MilesMayhew/Pedagogical-PCB/STM32 Resources/STM32_Pinout.jpeg

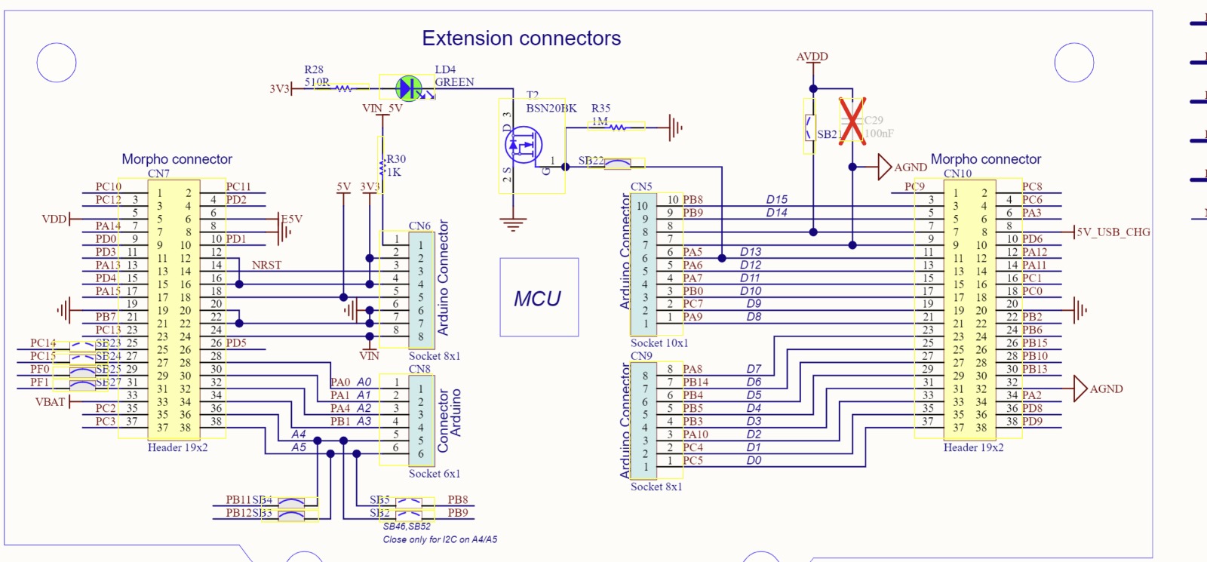
STM32 Resources/STM32_Pinout.jpeg
