MilesMayhew/Pedagogical-PCB/Reference Designs/Motor Driver Project 3d Model.jpg

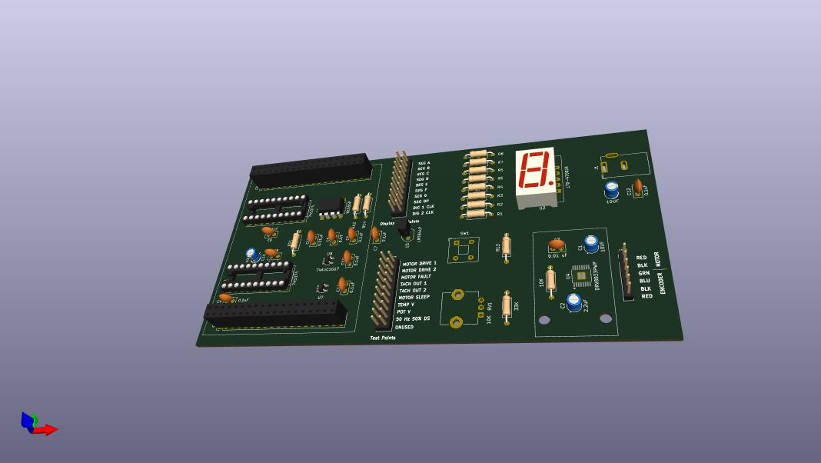
Reference Designs/Motor Driver Project 3d Model.jpg
