MilesMayhew/Pedagogical-PCB/Reference Designs/Motor Driver Project REV. 1.4.pdf

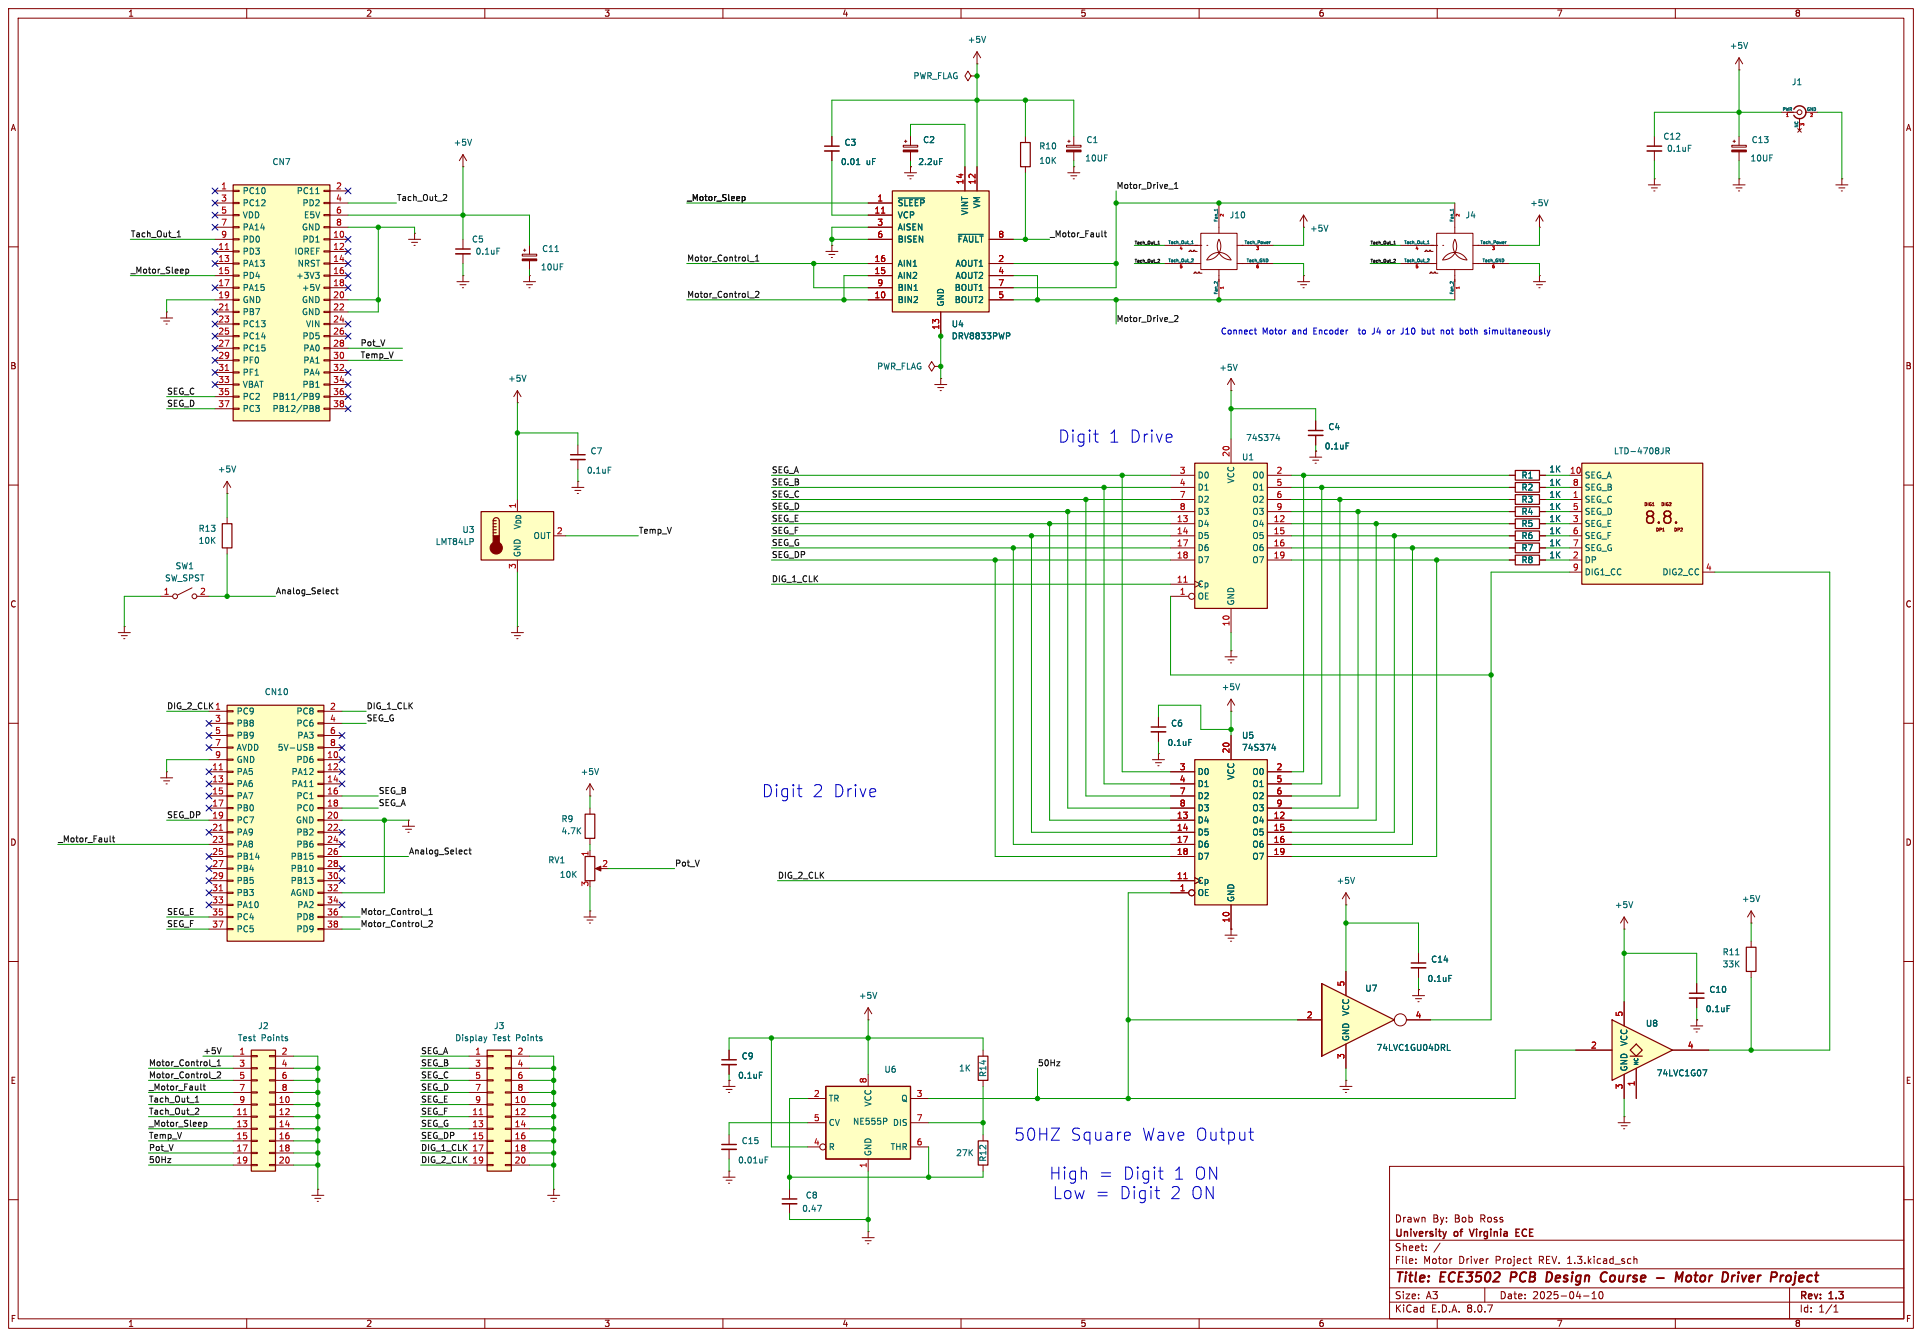
[picture p3: page 1]
