MilesMayhew/Pedagogical-PCB/PCBRev2/PCBRev2.kicad_pcb

## KiCad design PCBRev2/PCBRev2.kicad_pcb (2025-11-20)

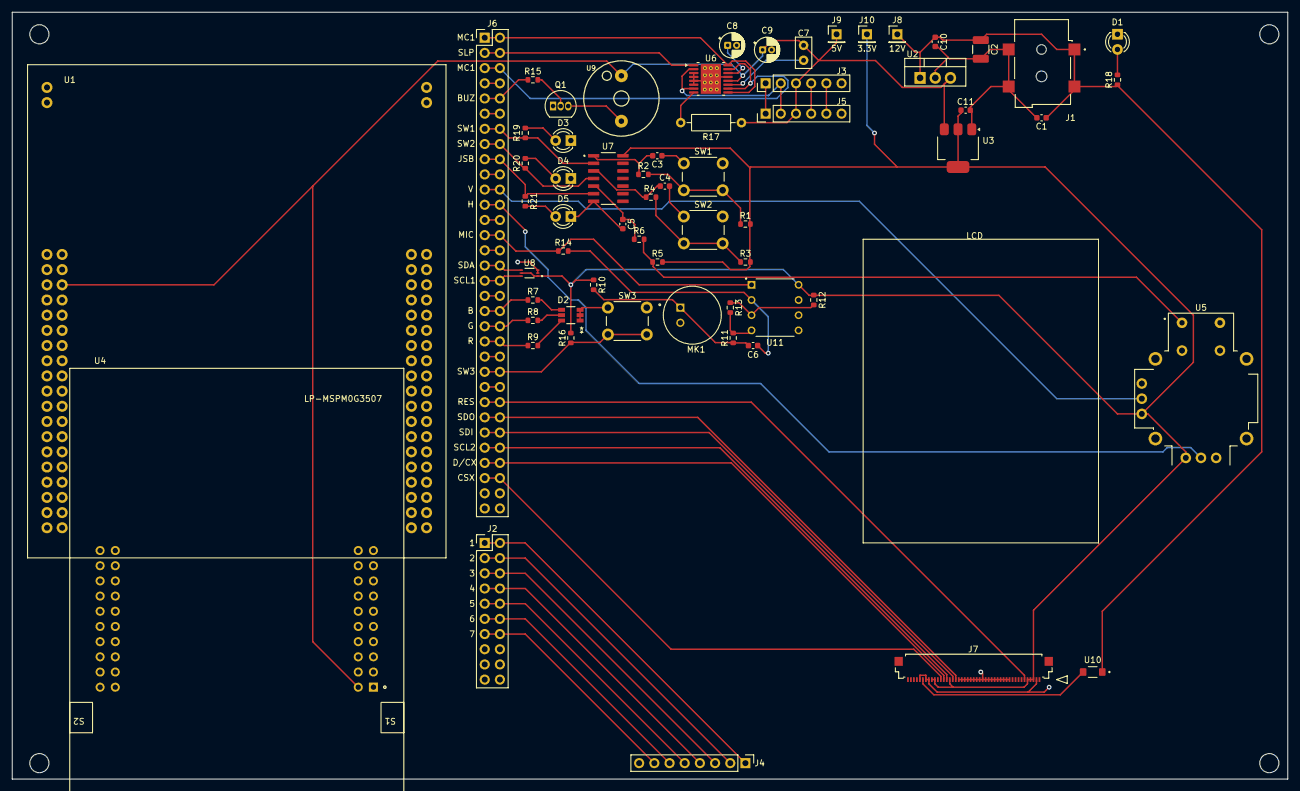
[picture p4: board PCBRev2.kicad_pcb from above]

Board: 2 copper layers, 213.4 x 128.3 mm, 63 parts (0 on the bottom side), 68 nets.

Parts:
C1: 0.1uf; C_0603_1608Metric
C2: 47uf; C_1210_3225Metric_Pad1.33x2.70mm_HandSolder
C3, C4, C5: 0.47uF; C_0603_1608Metric
C6: 1 uF; C_0603_1608Metric
C7: 0.01 uF; C_Disc_D5.0mm_W2.5mm_P2.50mm
C8: 2.2uF; CP_Radial_D4.0mm_P1.50mm
C9: 10UF; CP_Radial_D4.0mm_P1.50mm
C10: 0.22uf; C_0603_1608Metric
C11: 1uf; C_0603_1608Metric
D1, D3, D4, D5: LED; LED_D3.0mm_FlatTop
D2: AAAF3529LSEEZGKQBKS; LED_AAAF3529LSEEZGKQBKS_KNB
J1: 54-00164; TENSILITY_54-00164
J2: Conn_02x10_Odd_Even; PinHeader_2x10_P2.54mm_Vertical
J3, J5: PinHeader_1x06_P2.54mm_Vertical
J4: Keypad; PinHeader_1x08_P2.54mm_Vertical
J6: Conn_02x30_Odd_Even; PinHeader_2x32_P2.54mm_Vertical
J7: 512964594; CON_512964594_MOL
J8: 12V; PinHeader_1x01_P2.54mm_Vertical
J9: 5V; PinHeader_1x01_P2.54mm_Vertical
J10: 3.3V; PinHeader_1x01_P2.54mm_Vertical
MK1: CMA-4544PF-W; MIC_CMA-4544PF-W
Q1: 2N4401; TO-92_Inline
R1, R2, R3, R4, R5, R6, R16: 10kR; R_0603_1608Metric
R7, R8: 300; R_0603_1608Metric
R9: 750; R_0603_1608Metric
R10, R11, R12, R13: 2.2kR; R_0603_1608Metric
R14: 68k; R_0603_1608Metric
R15: 620; R_0603_1608Metric
R17: 10K; R_Axial_DIN0207_L6.3mm_D2.5mm_P10.16mm_Horizontal
R18: 510; R_0603_1608Metric
R19, R20: 68; R_0603_1608Metric
R21: 330; R_0603_1608Metric
SW1, SW2, SW3: SW_Push; SW_PUSH_6mm_H7.3mm
U1: NUCLEO-G0B1RE; MODULE_NUCLEO-G0B1RE
U2: LM7805_TO220; TO-220-3_Vertical
U3: TLV1117-33; SOT-223-3_TabPin2
U4: LP-MSPM0G3507; ti_LP_MSPM0G3507
U5: COM-09032; XDCR_COM-09032
U6: DRV8833PWP; HTSSOP-16-1EP_4.4x5mm_P0.65mm_EP3.4x5mm_Mask2.46x2.31mm_The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
U7: SN74AHCT14QDRG4Q1; SOIC127P600X175-14N
U8: BH1750FVI-TR; XDCR_BH1750FVI-TR
U9: WST-1205S
U10: AL5809-20QP1-7; SODFL3717X100N
U11: MCP6002-I_P; DIP787W46P254L927H533Q8

Connections:
+5V: C7.1, C9.1, J3.3 (Tach_Power), J5.3 (Tach_Power), J9.1, R17.1, U1.CN7_6 (E5V), U2.3 (VO), U3.3 (VI), U4.J3_1 (+VBUS), U6.12 (VM), U9.+
+12V: C1.1, C2.1, C10.1, J1.A1, J1.A2, J8.1, R18.1, U2.1 (VI), U10.1 (IN)
/Button1 Input: R1.1, R2.2, SW1.2
/Button2 Input: R3.1, R4.2, SW2.2
/Motor_Drive_1: J3.2 (Fan_1), J5.2 (Fan_1), U6.2 (AOUT1), U6.7 (BOUT1)
/Tach_Out_1: J3.4 (Tach_Out_1), J5.4 (Tach_Out_1)
/Tach_Out_2: J3.5 (Tach_Out_2), J5.5 (Tach_Out_2)
/_Motor_Fault: R17.2, U6.8 (~FAULT)
B: J6.37, J6.38, R7.1
ButtonNoDebounce: J6.45, J6.46, R16.1, SW3.2
BuzzerGPIO: J6.9, J6.10, R15.1
CSX: J6.59, J6.60, J7.34
D/CX: J6.57, J6.58, J7.33
G: J6.39, J6.40, R8.1
GNDREF: C1.2, C2.2, C3.1, C4.2, C5.2, C8.2, C9.2, C10.2, C11.2, D1.1 (K), D2.1, D2.2, D2.3, D3.1 (K), D4.1 (K), D5.1 (K), J1.B, J1.C, J3.1 (Fan_2), J3.6 (Tach_GND), J5.1 (Fan_2), J5.6 (Tach_GND), J7.2, J7.11, J7.12, J7.13, J7.14, J7.15, J7.16, J7.17, J7.18, J7.19, J7.20, J7.21, J7.22, J7.23, J7.24, J7.25, J7.26, J7.27, J7.28, J7.38, J7.39, J7.41, MK1.2, Q1.1 (S), R11.2, R13.2, SW1.1, SW2.1, SW3.1, U1.CN7_8 (GND), U1.CN7_19 (GND), U1.CN7_20 (GND), U1.CN7_22 (GND), U1.CN10_20 (GND), U1.JP4_1 (GND), U1.JP4_2 (GND), U1.JP5_1 (GND), U1.JP5_2 (GND), U2.2 (GND), U3.1 (GND), U4.J3_2 (GND), U5.B2A (SEL-), U5.H3 (H-), U5.S1 (SHIELD), U5.S2 (SHIELD), U5.S3 (SHIELD), U5.S4 (SHIELD), U5.V3 (V-), U6.3 (AISEN), U6.4 (AOUT2), U6.5 (BOUT2), U6.6 (BISEN), U6.13 (GND), U6.17 (GND), U7.7 (GND), U8.2 (ADDR), U8.3 (GND), U11.4 (VSS)
H: J6.23, J6.24, U5.H2 (H)
JSB: J6.17, J6.18, R21.1, U7.6 (3Y)
MicOut: J6.27, J6.28, R14.1, U11.1 (VOUTA)
MotorControl1: J6.1, J6.2, U6.9 (BIN1), U6.16 (AIN1)
MotorControl2: J6.5, J6.6, U6.10 (BIN2), U6.15 (AIN2)
Motor_Sleep: J6.3, J6.4, U6.1 (~SLEEP)
unnamed: C6.1, MK1.1, R10.2, R11.1
unnamed: D1.2 (A), R18.2
unnamed: D2.4, R7.2
unnamed: D2.5, R8.2
unnamed: D2.6, R9.2
unnamed: D3.2 (A), R19.2
unnamed: D4.2 (A), R20.2
unnamed: D5.2 (A), R21.2
unnamed: J2.1, J2.2, J4.1
unnamed: J2.3, J2.4, J4.2
unnamed: J2.5, J2.6, J4.3
unnamed: J2.7, J2.8, J4.4
unnamed: J2.9, J2.10, J4.5
unnamed: J2.11, J2.12, J4.6
unnamed: J2.13, J2.14, J4.7
unnamed: J6.7, J6.8
unnamed: J6.11, J6.12
unnamed: J6.19, J6.20
unnamed: J6.25, J6.26
unnamed: J6.29, J6.30
unnamed: J6.35, J6.36
unnamed: J6.43, J6.44
unnamed: J6.47, J6.48
unnamed: Q1.3 (D), U9.-
unnamed: Q1.2 (G), R15.2
unnamed: U1.CN7_12 (3V3), U1.CN7_16 (3V3)
unnamed: U1.CN10_9 (AGND), U1.CN10_32 (AGND)
unnamed: R5.1, R6.2, U5.B1A (SEL+)
unnamed: C7.2, U6.11 (VCP)
unnamed: C8.1, U6.14 (VINT)
unnamed: C3.2, R2.1, U7.1 (1A)
unnamed: C4.1, R4.1, U7.3 (2A)
unnamed: C5.1, R6.1, U7.5 (3A)
unnamed: J7.40, U10.2 (OUT)
unnamed: R12.2, R13.1, U11.3 (VINA+)
unnamed: C6.2, R14.2, U11.2 (VINA-)
R: J6.41, J6.42, R9.1
RESX: J6.49, J6.50, J7.6
SCL: J6.55, J6.56, J7.32
SCLlight: J6.33, J6.34, U8.6 (SCL)
SDA: J6.31, J6.32, U8.4 (SDA)
SDI: J6.53, J6.54, J7.30
SDO: J6.51, J6.52, J7.29
SW1: J6.13, J6.14, R19.1, U7.2 (1Y)
SW2: J6.15, J6.16, R20.1, U7.4 (2Y)
V: J6.21, J6.22, U5.V2 (V)
VDD: C11.1, J7.3, J7.4, J7.5, J7.31, J7.36, J7.37, J10.1, R1.2, R3.2, R5.2, R10.1, R12.1, R16.2, U3.2 (VO), U5.H1 (H+), U5.V1 (V+), U7.14 (VCC), U8.1 (VCC), U8.5 (DVI), U11.8 (VDD)
