MilesMayhew/Pedagogical-PCB/CapstonePCB/CapstonePCB.kicad_pcb

## KiCad design CapstonePCB/CapstonePCB.kicad_pcb (2025-10-28)

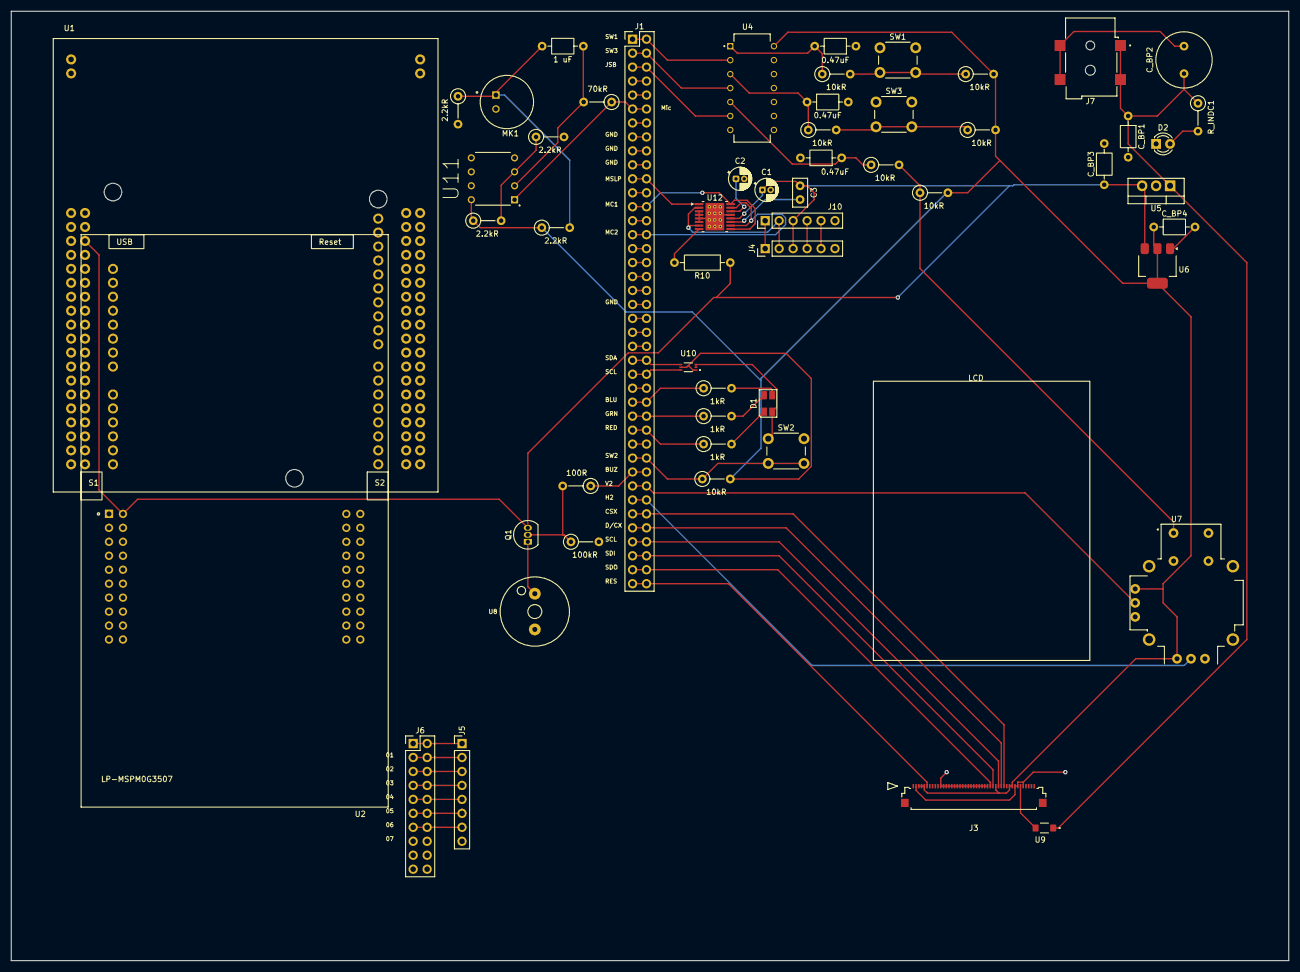
[picture p5: board CapstonePCB.kicad_pcb from above]

Board: 2 copper layers, 232.4 x 172.7 mm, 55 parts (0 on the bottom side), 93 nets.

Parts:
C1: 10UF; CP_Radial_D4.0mm_P1.50mm
C2: 2.2uF; CP_Radial_D4.0mm_P1.50mm
C3: 0.01 uF; C_Disc_D5.0mm_W2.5mm_P2.50mm
CJS1: 0.47uF; C_Axial_L3.8mm_D2.6mm_P7.50mm_Horizontal
CSW1, CSW3: 0.47uF; C_Axial_L3.8mm_D2.6mm_P7.50mm_Horizontal
C_BP1: 0.1 uf; C_Axial_L3.8mm_D2.6mm_P7.50mm_Horizontal
C_BP2: 47 uf; C_Radial_D10.0mm_H20.0mm_P5.00mm
C_BP3, C_BP4: 100 uf; C_Axial_L3.8mm_D2.6mm_P7.50mm_Horizontal
C_s2: 1 uF; C_Axial_L3.8mm_D2.6mm_P7.50mm_Horizontal
D1: ASMB-MTB1-0A3A2; LED_Avago_PLCC4_3.2x2.8mm_CW
D2: LED; LED_D3.0mm_FlatTop
J1: Conn_02x40_Counter_Clockwise; PinHeader_2x40_P2.54mm_Vertical
J3: 512964594; CON_512964594_MOL
J4, J10: PinHeader_1x06_P2.54mm_Vertical
J5: Keypad; PinHeader_1x08_P2.54mm_Vertical
J6: Conn_02x10_Odd_Even; PinHeader_2x10_P2.54mm_Vertical
J7: 54-00164; TENSILITY_54-00164
MK1: CMA-4544PF-W; MIC_CMA-4544PF-W
PullUpResistor2: 10kR; R_Axial_DIN0207_L6.3mm_D2.5mm_P5.08mm_Vertical
PullUpResistorJS1: 10kR; R_Axial_DIN0207_L6.3mm_D2.5mm_P5.08mm_Vertical
PullUpResistorSW1, PullUpResistorSW3: 10kR; R_Axial_DIN0207_L6.3mm_D2.5mm_P5.08mm_Vertical
Q1: 2N7000; TO-92_Inline
R10: 10K; R_Axial_DIN0207_L6.3mm_D2.5mm_P10.16mm_Horizontal
RJS1: 10kR; R_Axial_DIN0207_L6.3mm_D2.5mm_P5.08mm_Vertical
RSW1, RSW3: 10kR; R_Axial_DIN0207_L6.3mm_D2.5mm_P5.08mm_Vertical
R_BUZ1: 100R; R_Axial_DIN0207_L6.3mm_D2.5mm_P5.08mm_Vertical
R_BUZ2: 100kR; R_Axial_DIN0207_L6.3mm_D2.5mm_P5.08mm_Vertical
R_COFF2, R_COFF3, R_COFF4: 1kR; R_Axial_DIN0207_L6.3mm_D2.5mm_P5.08mm_Vertical
R_INDC1: 5.5k ohm; R_Axial_DIN0207_L6.3mm_D2.5mm_P5.08mm_Vertical
R_SNSA2, R_SNSA3, R_SNSA5, R_SNSA6: 2.2kR; R_Axial_DIN0207_L6.3mm_D2.5mm_P5.08mm_Vertical
R_SNSA4: 70kR; R_Axial_DIN0207_L6.3mm_D2.5mm_P5.08mm_Vertical
SW1, SW2, SW3: SW_Push; SW_PUSH_6mm_H7.3mm
U1: NUCLEO-G0B1RE; MODULE_NUCLEO-G0B1RE
U2: LP-MSPM0G3507; ti_LP_MSPM0G3507
U4: SN74AHC14N; DIP794W45P254L1969H508Q14
U5: LM7805_TO220; TO-220-3_Vertical
U6: TLV1117-33; SOT-223-3_TabPin2
U7: COM-09032; XDCR_COM-09032
U8: WST-1205S
U9: AL5809-20QP1-7; SODFL3717X100N
U10: BH1750FVI-TR; XDCR_BH1750FVI-TR
U11: MCP6002-I_P; DIP787W46P254L927H533Q8
U12: DRV8833PWP; HTSSOP-16-1EP_4.4x5mm_P0.65mm_EP3.4x5mm_Mask2.46x2.31mm_The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

Connections:
+3.3V: U1.CN6_2 (3V3), U1.CN6_4 (3V3), U1.CN7_12 (3V3), U1.CN7_16 (3V3)
+5V: C1.1, C3.1, C_BP3.1, J4.3 (Tach_Power), J10.3 (Tach_Power), Q1.3 (D), R10.1, U1.CN7_6 (E5V), U2.J3_1 (+VBUS), U5.3 (VO), U6.3 (VI), U12.12 (VM)
+12V: C_BP1.1, C_BP2.1, J7.A1, J7.A2, R_INDC1.1, U5.1 (VI), U9.1 (IN)
/Button1 Input: PullUpResistorSW1.1, RSW1.2, SW1.2
/Button2 Input: PullUpResistorSW3.1, RSW3.2, SW3.2
/Button No Debouning: J1.61, J1.62, PullUpResistor2.1, SW2.2
/Motor_Drive_1: J4.2 (Fan_1), J10.2 (Fan_1), U12.2 (AOUT1), U12.7 (BOUT1)
/Tach_Out_1: J4.4 (Tach_Out_1), J10.4 (Tach_Out_1)
/Tach_Out_2: J4.5 (Tach_Out_2), J10.5 (Tach_Out_2)
/_Motor_Fault: R10.2, U12.8 (~FAULT)
BuzzerGPIO: J1.63, J1.64, R_BUZ1.1
GNDREF: C1.2, C2.2, CJS1.2, CSW1.1, CSW3.2, C_BP1.2, C_BP2.2, C_BP3.2, C_BP4.2, D1.4 (A), D2.1 (K), J1.15, J1.16, J1.17, J1.18, J1.19, J1.20, J1.27, J1.28, J1.39, J1.40, J3.2, J3.11, J3.12, J3.13, J3.14, J3.15, J3.16, J3.17, J3.18, J3.19, J3.20, J3.21, J3.22, J3.23, J3.24, J3.25, J3.26, J3.27, J3.28, J3.38, J3.39, J3.41, J4.1 (Fan_2), J4.6 (Tach_GND), J7.B, J7.C, J10.1 (Fan_2), J10.6 (Tach_GND), MK1.2, R_BUZ2.2, R_SNSA3.2, R_SNSA6.2, SW1.1, SW2.1, SW3.1, U1.CN6_6 (GND), U1.CN6_7 (GND), U1.CN7_8 (GND), U1.CN7_19 (GND), U1.CN7_20 (GND), U1.CN7_22 (GND), U1.CN10_20 (GND), U1.JP4_1 (GND), U1.JP4_2 (GND), U1.JP5_1 (GND), U1.JP5_2 (GND), U2.J3_2 (GND), U4.7 (GND), U5.2 (GND), U6.1 (GND), U7.B2A (SEL-), U7.H3 (H-), U7.S1 (SHIELD), U7.S2 (SHIELD), U7.S3 (SHIELD), U7.S4 (SHIELD), U7.V3 (V-), U8.-, U10.2 (ADDR), U10.3 (GND), U11.4 (VSS), U12.3 (AISEN), U12.4 (AOUT2), U12.5 (BOUT2), U12.6 (BISEN), U12.13 (GND), U12.17 (GND)
MicOut: J1.11, J1.12, R_SNSA4.1, U11.1 (VOUTA)
MotorControl1: J1.25, J1.26, U12.9 (BIN1), U12.16 (AIN1)
MotorControl2: J1.29, J1.30, U12.10 (BIN2), U12.15 (AIN2)
Motor_Sleep: J1.21, J1.22, U12.1 (~SLEEP)
unnamed: C_s2.1, MK1.1, R_SNSA2.2, R_SNSA3.1
unnamed: D1.3 (BK), R_COFF4.2
unnamed: D1.2 (GK), R_COFF3.2
unnamed: D1.1 (RK), R_COFF2.2
unnamed: D2.2 (A), R_INDC1.2
unnamed: J1.1, J1.2, U4.2 (1Y)
unnamed: J1.3, J1.4, U4.4 (2Y)
unnamed: J1.5, J1.6, U4.6 (3Y)
unnamed: J1.7, J1.8
unnamed: J1.9, J1.10
unnamed: J1.13, J1.14
unnamed: J1.23, J1.24
unnamed: J1.31, J1.32
unnamed: J1.33, J1.34
unnamed: J1.35, J1.36
unnamed: J1.37, J1.38
unnamed: J1.41, J1.42
unnamed: J1.43, J1.44
unnamed: J1.45, J1.46
unnamed: J1.47, J1.48, U10.4 (SDA)
unnamed: J1.49, J1.50, U10.6 (SCL)
unnamed: J1.51, J1.52
unnamed: J1.53, J1.54, R_COFF4.1
unnamed: J1.55, J1.56, R_COFF3.1
unnamed: J1.57, J1.58, R_COFF2.1
unnamed: J1.59, J1.60
unnamed: J1.65, J1.66, U7.V2 (V)
unnamed: J1.67, J1.68, U7.H2 (H)
unnamed: J1.69, J1.70, J3.34
unnamed: J1.71, J1.72, J3.33
unnamed: J1.73, J1.74, J3.32
unnamed: J1.75, J1.76, J3.30
unnamed: J1.77, J1.78, J3.29
unnamed: J1.79, J1.80, J3.6
unnamed: J5.1, J6.1, J6.2
unnamed: J5.2, J6.3, J6.4
unnamed: J5.3, J6.5, J6.6
unnamed: J5.4, J6.7, J6.8
unnamed: J5.5, J6.9, J6.10
unnamed: J5.6, J6.11, J6.12
unnamed: J5.7, J6.13, J6.14
unnamed: Q1.2 (G), R_BUZ1.2, R_BUZ2.1
unnamed: Q1.1 (S), U8.+
unnamed: U1.CN7_28 (PA0), U1.CN8_1 (PA0)
unnamed: U1.CN7_30 (PA1), U1.CN8_2 (PA1)
unnamed: U1.CN7_32 (PA4), U1.CN8_3 (PA4)
unnamed: U1.CN5_6 (PA5), U1.CN10_11 (PA5)
unnamed: U1.CN5_5 (PA6), U1.CN10_13 (PA6)
unnamed: U1.CN5_4 (PA7), U1.CN10_15 (PA7)
unnamed: U1.CN9_8 (PA8), U1.CN10_23 (PA8)
unnamed: U1.CN5_1 (PA9), U1.CN10_21 (PA9)
unnamed: U1.CN9_3 (PA10), U1.CN10_33 (PA10)
unnamed: U1.CN5_3 (PB0), U1.CN10_17 (PB0)
unnamed: U1.CN7_34 (PB1), U1.CN8_4 (PB1)
unnamed: U1.CN9_4 (PB3), U1.CN10_31 (PB3)
unnamed: U1.CN9_6 (PB4), U1.CN10_27 (PB4)
unnamed: U1.CN9_5 (PB5), U1.CN10_29 (PB5)
unnamed: U1.CN5_10 (PB8), U1.CN10_3 (PB8)
unnamed: U1.CN5_9 (PB9), U1.CN10_5 (PB9)
unnamed: U1.CN9_7 (PB14), U1.CN10_25 (PB14)
unnamed: U1.CN9_2 (PC4), U1.CN10_35 (PC4)
unnamed: U1.CN9_1 (PC5), U1.CN10_37 (PC5)
unnamed: U1.CN5_2 (PC7), U1.CN10_19 (PC7)
unnamed: U1.CN6_3 (~RST), U1.CN7_14 (~RST)
unnamed: U1.CN6_5 (5V), U1.CN7_18 (5V)
unnamed: U1.CN5_7 (AGND), U1.CN10_9 (AGND), U1.CN10_32 (AGND)
unnamed: U1.CN6_8 (VIN), U1.CN7_24 (VIN)
unnamed: CSW1.2, RSW1.1, U4.1 (1A)
unnamed: CSW3.1, RSW3.1, U4.3 (2A)
unnamed: CJS1.1, RJS1.1, U4.5 (3A)
unnamed: PullUpResistorJS1.1, RJS1.2, U7.B1A (SEL+)
unnamed: J3.40, U9.2 (OUT)
unnamed: R_SNSA5.2, R_SNSA6.1, U11.3 (VINA+)
unnamed: C_s2.2, R_SNSA4.2, U11.2 (VINA-)
unnamed: C3.2, U12.11 (VCP)
unnamed: C2.1, U12.14 (VINT)
VDD: C_BP4.1, J3.3, J3.4, J3.5, J3.31, J3.36, J3.37, PullUpResistor2.2, PullUpResistorJS1.2, PullUpResistorSW1.2, PullUpResistorSW3.2, R_SNSA2.1, R_SNSA5.1, U4.14 (VCC), U6.2 (VO), U7.H1 (H+), U7.V1 (V+), U10.1 (VCC), U10.5 (DVI), U11.8 (VDD)
