MilesMayhew/Pedagogical-PCB/Reference Designs/Motor Driver Project REV. 1.4.kicad_pcb

## KiCad design Reference Designs/Motor Driver Project REV. 1.4.kicad_pcb (2025-10-03)

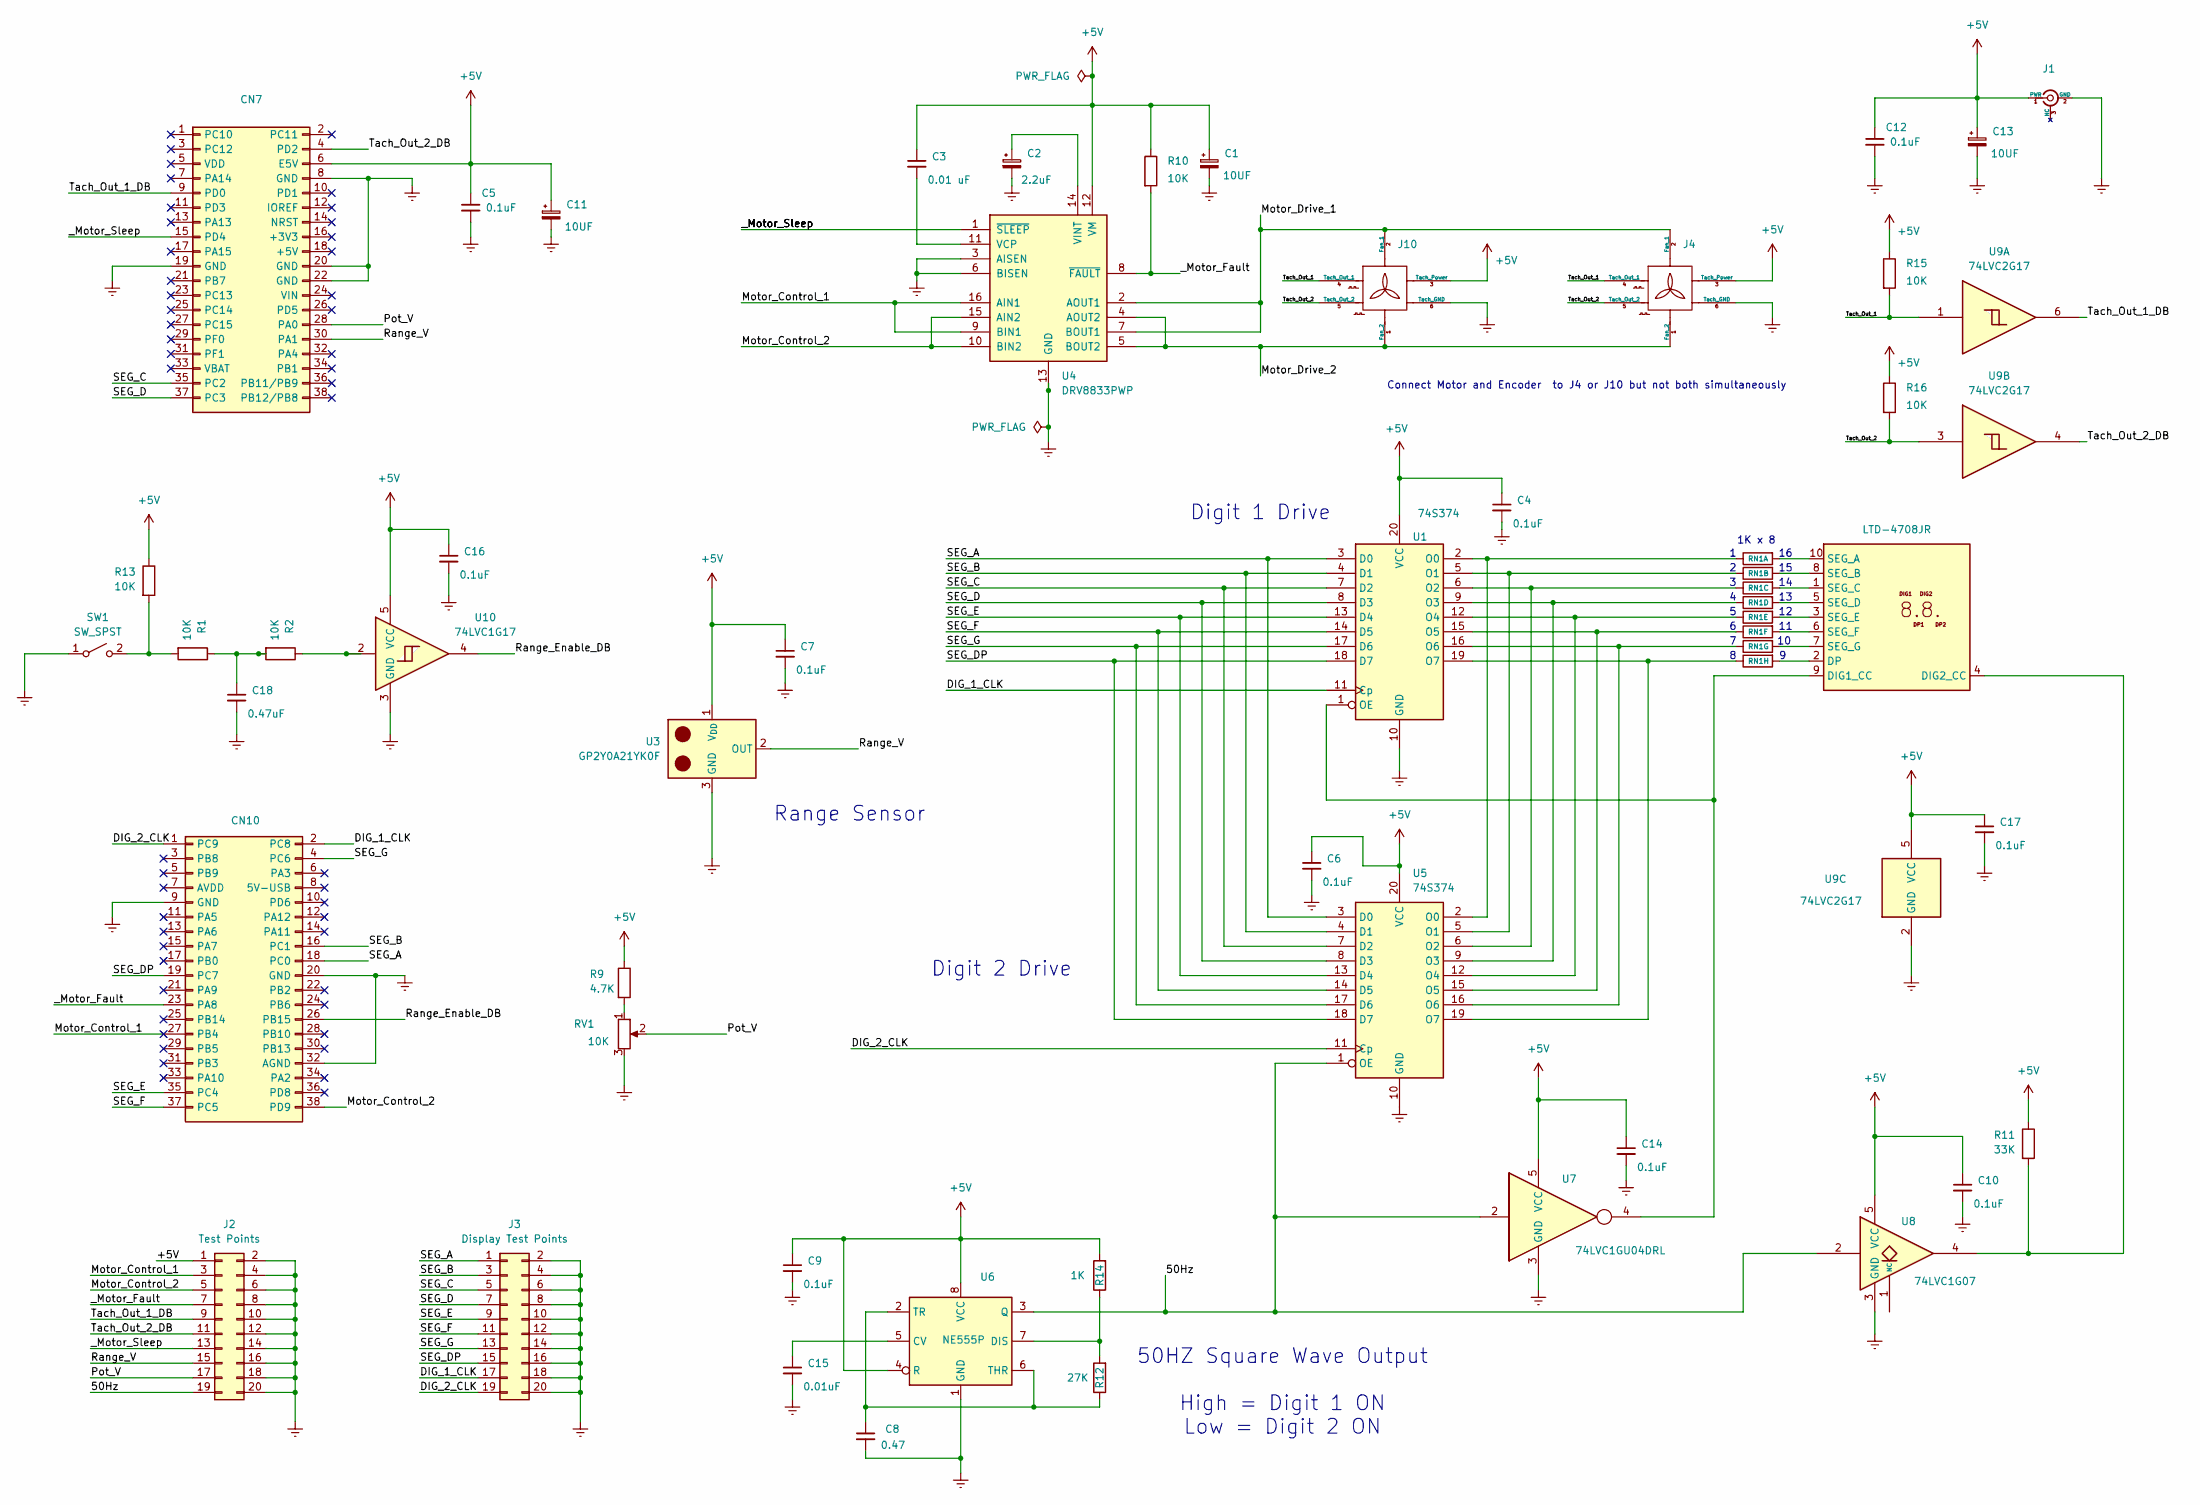
[picture p6: schematic Motor Driver Project REV. 1.4.kicad_sch, ECE3502 PCB Design Course - Motor Driver Project]

Parts:
C1, C11, C13: 10UF; CP_Radial_D4.0mm_P1.50mm
C2: 2.2uF; CP_Radial_D4.0mm_P1.50mm
C3: 0.01 uF; C_Disc_D5.0mm_W2.5mm_P2.50mm
C4, C5, C6, C7, C9, C10, C12, C14, C16, C17: 0.1uF; C_Disc_D5.0mm_W2.5mm_P2.50mm
C8: 0.47; C_Disc_D5.0mm_W2.5mm_P2.50mm
C15: 0.01uF; C_Disc_D5.0mm_W2.5mm_P2.50mm
C18: 0.47uF; C_Disc_D5.0mm_W2.5mm_P2.50mm
CN7: Conn_2Rows-38Pins_CN7; PinSocket_2x19_P2.54mm_Vertical_CN7
CN10: Conn_2Rows-38Pins_CN10; PinSocket_2x19_P2.54mm_Vertical_CN10
J1: Conn_Coaxial_3_Pin; BarrelJack_GCT_DCJ200-10-A_Horizontal
J2: Test Points; PinHeader_2x10_P2.54mm_Vertical
J3: Display Test Points; PinHeader_2x10_P2.54mm_Vertical
J4, J10: PinHeader_1x06_P2.54mm_Vertical
R1, R2, R10, R13, R15, R16: 10K; R_Axial_DIN0207_L6.3mm_D2.5mm_P10.16mm_Horizontal
R9: 4.7K; R_Axial_DIN0207_L6.3mm_D2.5mm_P10.16mm_Horizontal
R11: 33K; R_Axial_DIN0207_L6.3mm_D2.5mm_P10.16mm_Horizontal
R12: 27K; R_Axial_DIN0207_L6.3mm_D2.5mm_P10.16mm_Horizontal
R14: 1K; R_Axial_DIN0207_L6.3mm_D2.5mm_P10.16mm_Horizontal
RN1: R_Pack08_Split; DIP-16_W7.62mm
RV1: 10K; TRIM_COM-09806
SW1: SW_SPST; SW2_GF-123-0054_CWI
U1, U5: 74S374; DIP-20_W7.62mm_Socket
U2: LTD-4708JR; 7SegmentLED_LTD-4708JR
U3: GP2Y0A21YK0F; PinHeader_1x03_P2.54mm_Vertical
U4: DRV8833PWP; HTSSOP-16-1EP_4.4x5mm_P0.65mm_EP3.4x5mm_Mask2.46x2.31mm_The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
U6: NE555P; DIP-8_W7.62mm
U7: 74LVC1GU04DRL; SOT-23-5_HandSoldering
U8: 74LVC1G07; SOT-23-5_HandSoldering
U9: 74LVC2G17; SOT-23-6
U10: 74LVC1G17; SOT-23-5

Connections:
+5V: C1.1, C3.1, C4.1, C5.1, C6.1, C7.1, C9.1, C10.1, C11.1, C12.1, C13.1, C14.1, C16.1, C17.1, CN7.6 (E5V), J1.1 (PWR), J2.1, J4.3 (Tach_Power), J10.3 (Tach_Power), R9.1, R10.1, R11.1, R13.1, R14.2, R15.1, R16.1, U1.20 (VCC), U3.1 (V_{DD}), U4.12 (VM), U5.20 (VCC), U6.4 (R), U6.8 (VCC), U7.5 (VCC), U8.5 (VCC), U9.5 (VCC), U10.5 (VCC)
/50Hz: J2.19, U5.1 (OE), U6.3 (Q), U7.2, U8.2
/DIG_1_CLK: CN10.2 (PC8), J3.17, U1.11 (Cp)
/DIG_2_CLK: CN10.1 (PC9), J3.19, U5.11 (Cp)
/Motor_Control_1: CN10.27 (PB4), J2.3, U4.9 (BIN1), U4.16 (AIN1)
/Motor_Control_2: CN10.38 (PD9), J2.5, U4.10 (BIN2), U4.15 (AIN2)
/Motor_Drive_1: J4.2 (Fan_1), J10.2 (Fan_1), U4.2 (AOUT1), U4.7 (BOUT1)
/Motor_Drive_2: J4.1 (Fan_2), J10.1 (Fan_2), U4.4 (AOUT2), U4.5 (BOUT2)
/Pot_V: CN7.28 (PA0), J2.17, RV1.2
/Range_Enable_DB: CN10.26 (PB15), U10.4
/Range_V: CN7.30 (PA1), J2.15, U3.2 (OUT)
/SEG_A: CN10.18 (PC0), J3.1, U1.3 (D0), U5.3 (D0)
/SEG_B: CN10.16 (PC1), J3.3, U1.4 (D1), U5.4 (D1)
/SEG_C: CN7.35 (PC2), J3.5, U1.7 (D2), U5.7 (D2)
/SEG_D: CN7.37 (PC3), J3.7, U1.8 (D3), U5.8 (D3)
/SEG_DP: CN10.19 (PC7), J3.15, U1.18 (D7), U5.18 (D7)
/SEG_E: CN10.35 (PC4), J3.9, U1.13 (D4), U5.13 (D4)
/SEG_F: CN10.37 (PC5), J3.11, U1.14 (D5), U5.14 (D5)
/SEG_G: CN10.4 (PC6), J3.13, U1.17 (D6), U5.17 (D6)
/Tach_Out_1: J4.4 (Tach_Out_1), J10.4 (Tach_Out_1), R15.2, U9.1
/Tach_Out_1_DB: CN7.9 (PD0), J2.9, U9.6
/Tach_Out_2: J4.5 (Tach_Out_2), J10.5 (Tach_Out_2), R16.2, U9.3
/Tach_Out_2_DB: CN7.4 (PD2), J2.11, U9.4
/_Motor_Fault: CN10.23 (PA8), J2.7, R10.2, U4.8 (~FAULT)
/_Motor_Sleep: CN7.15 (PD4), J2.13, U4.1 (~SLEEP)
Earth: C1.2, C2.2, C4.2, C5.2, C6.2, C7.2, C8.2, C9.2, C10.2, C11.2, C12.2, C13.2, C14.2, C15.2, C16.2, C17.2, C18.2, CN7.8 (GND), CN7.19 (GND), CN7.20 (GND), CN7.22 (GND), CN10.9 (GND), CN10.20 (GND), CN10.32 (AGND), J1.2 (GND), J2.2, J2.4, J2.6, J2.8, J2.10, J2.12, J2.14, J2.16, J2.18, J2.20, J3.2, J3.4, J3.6, J3.8, J3.10, J3.12, J3.14, J3.16, J3.18, J3.20, J4.6 (Tach_GND), J10.6 (Tach_GND), RV1.3, SW1.1 (A), U1.10 (GND), U3.3 (GND), U4.3 (AISEN), U4.6 (BISEN), U4.13 (GND), U4.17 (GND), U5.10 (GND), U6.1 (GND), U7.3 (GND), U8.3 (GND), U9.2 (GND), U10.3 (GND)
unnamed: C18.1, R1.1, R2.2
unnamed: R2.1, U10.2
unnamed: R9.2, RV1.1
unnamed: RN1.1 (R1.1), U1.2 (O0), U5.2 (O0)
unnamed: RN1.16 (R1.2), U2.10 (SEG_A)
unnamed: RN1.2 (R2.1), U1.5 (O1), U5.5 (O1)
unnamed: RN1.15 (R2.2), U2.8 (SEG_B)
unnamed: RN1.3 (R3.1), U1.6 (O2), U5.6 (O2)
unnamed: RN1.14 (R3.2), U2.1 (SEG_C)
unnamed: RN1.4 (R4.1), U1.9 (O3), U5.9 (O3)
unnamed: RN1.13 (R4.2), U2.5 (SEG_D)
unnamed: RN1.5 (R5.1), U1.12 (O4), U5.12 (O4)
unnamed: RN1.12 (R5.2), U2.3 (SEG_E)
unnamed: RN1.6 (R6.1), U1.15 (O5), U5.15 (O5)
unnamed: RN1.11 (R6.2), U2.6 (SEG_F)
unnamed: RN1.7 (R7.1), U1.16 (O6), U5.16 (O6)
unnamed: RN1.10 (R7.2), U2.7 (SEG_G)
unnamed: RN1.8 (R8.1), U1.19 (O7), U5.19 (O7)
unnamed: RN1.9 (R8.2), U2.2 (DP)
unnamed: R1.2, R13.2, SW1.2 (B)
unnamed: U1.1 (OE), U2.9 (DIG1_CC), U7.4
unnamed: R11.2, U2.4 (DIG2_CC), U8.4
unnamed: C3.2, U4.11 (VCP)
unnamed: C2.1, U4.14 (VINT)
unnamed: C15.1, U6.5 (CV)
unnamed: R12.2, R14.1, U6.7 (DIS)
unnamed: C8.1, R12.1, U6.2 (TR), U6.6 (THR)

Notes on the sheet:
Range Sensor
50HZ Square Wave Output High = Digit 1 ON Low = Digit 2 ON
Digit 1 Drive
Connect Motor and Encoder to J4 or J10 but not both simultaneously
Digit 2 Drive
1K x 8

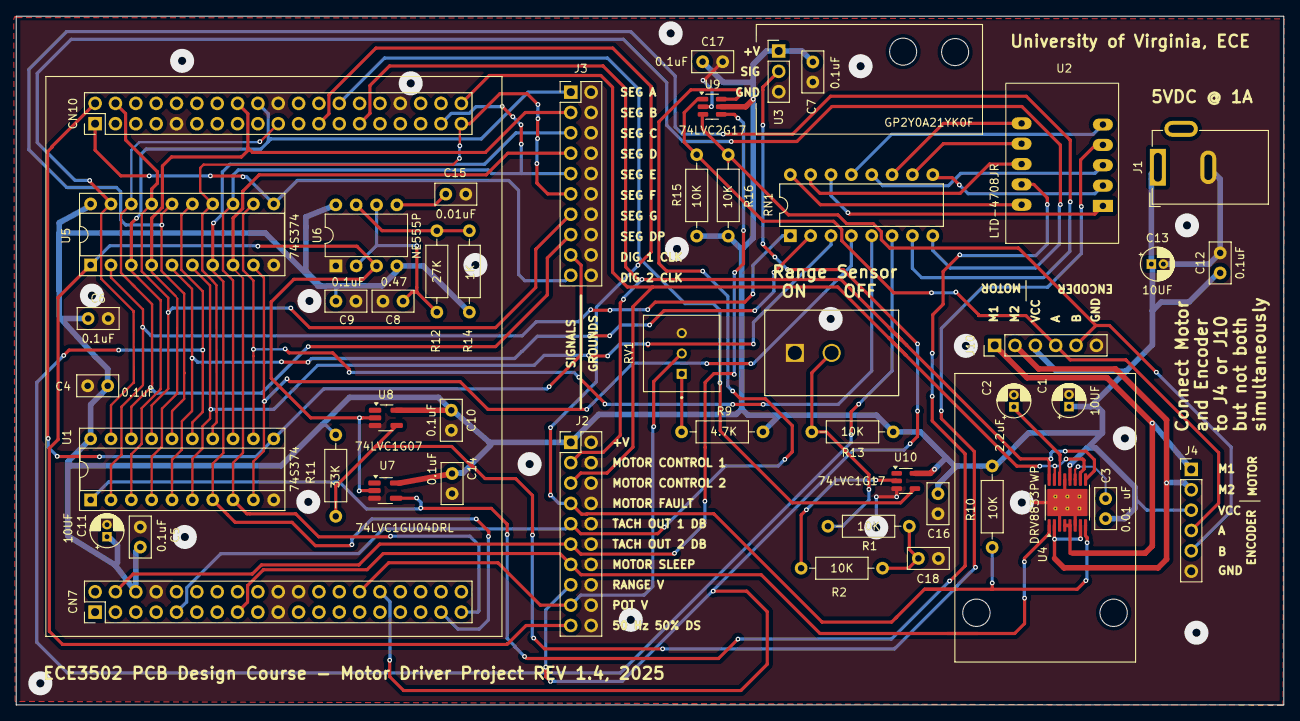
[picture p7: board Motor Driver Project REV. 1.4.kicad_pcb from above]

Board: 2 copper layers, 158.2 x 86.0 mm, 48 parts (0 on the bottom side), 53 nets.
