MilesMayhew/Pedagogical-PCB/STM32 Software Solutions/Joystick/Core/Src/main.c

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
/* Includes ------------------------------------------------------------------*/
#include "main.h"

/* USER CODE BEGIN Includes */
#include "joystick.h"
/* USER CODE END Includes */

/* USER CODE BEGIN PM */
void HAL_UART_PrintFloat(float value, uint8_t decimals);
void HAL_UART_Print(const char *s);
/* USER CODE END PM */

ADC_HandleTypeDef hadc1;
DMA_HandleTypeDef hdma_adc1;

UART_HandleTypeDef huart2;

void SystemClock_Config(void);
static void MX_GPIO_Init(void);
static void MX_DMA_Init(void);
static void MX_ADC1_Init(void);
static void MX_USART2_UART_Init(void);
/**
  * @brief  The application entry point.
  * @retval int
  */
int main(void)
{

  /* MCU Configuration--------------------------------------------------------*/

  /* Reset of all peripherals, Initializes the Flash interface and the Systick. */
  HAL_Init();

  /* Configure the system clock */
  SystemClock_Config();

  /* Initialize all configured peripherals */
  MX_GPIO_Init();
  MX_DMA_Init();
  MX_ADC1_Init();
  MX_USART2_UART_Init();
  /* USER CODE BEGIN 2 */
  HAL_UART_Print("UART OK\r\n");
  HAL_Delay(500);

  Joystick_Init(&hadc1);

  HAL_UART_Print("UART STILL OK\r\n");
  HAL_Delay(500);

  Joystick_Start();
  /* USER CODE END 2 */

  /* Infinite loop */
  /* USER CODE BEGIN WHILE */
  HAL_UART_Print("Starting Joystick Read!");

  while (1)
  {
	  	Joystick_t js = Joystick_Get();
	  	Joystick_Process();
//	    HAL_UART_Print("X_raw: ");
//	    HAL_UART_PrintFloat((float)js.rawX, 0);

//	    HAL_UART_Print("   Y_raw: ");
//	    HAL_UART_PrintFloat((float)js.rawY, 0);

	    HAL_UART_Print("   X_norm: ");
	    HAL_UART_PrintFloat(js.normX, 3);

	    HAL_UART_Print("   Y_norm: ");
	    HAL_UART_PrintFloat(js.normY, 3);

	    HAL_UART_Print("\r\n");

	    HAL_Delay(50);

    /* USER CODE END WHILE */

    /* USER CODE BEGIN 3 */
  }
  /* USER CODE END 3 */
}

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
/* USER CODE BEGIN 4 */
void HAL_UART_PrintChar(char c)
{
    HAL_UART_Transmit(&huart2, (uint8_t*)&c, 1, HAL_MAX_DELAY);
}

void HAL_UART_Print(const char *s)
{
    while (*s)
        HAL_UART_PrintChar(*s++);
}
void HAL_UART_PrintFloat(float value, uint8_t decimals)
{
    // Handle negative numbers
    if (value < 0) {
        HAL_UART_PrintChar('-');
        value = -value;
    }

    // Extract integer part
    uint32_t intPart = (uint32_t)value;

    // Extract fractional part
    float fpart = value - (float)intPart;

    // Print integer part manually
    char buffer[12];
    int i = 0;

    do {
        buffer[i++] = (intPart % 10) + '0';
        intPart /= 10;
    } while (intPart > 0);

    // Print in correct order
    while (i > 0) {
        HAL_UART_PrintChar(buffer[--i]);
    }

    // Decimal point
    if (decimals > 0) {
        HAL_UART_PrintChar('.');

        // Multiply out fractional digits
        for (int d = 0; d < decimals; d++) {
            fpart *= 10.0f;
            int digit = (int)fpart;
            HAL_UART_PrintChar('0' + digit);
            fpart -= digit;
        }
    }
}

/* USER CODE END 4 */
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
