MilesMayhew/Pedagogical-PCB/STM32 Software Solutions/Joystick/Joystick.ioc

Mcu.UserName=STM32G071RBTx
PA0.Signal=ADC1_IN0
PA1.Signal=ADC1_IN1
PA2.Signal=USART2_TX
PA3.Signal=USART2_RX
