MilesMayhew/Pedagogical-PCB/(commit log)

2025-09-23 Updated title on silkscreen
    [CapstonePCB.kicad_pcb]
2025-09-23 Test commit
    [CapstonePCB.kicad_pcb]
2025-09-29 Added MSPM0 outline to schematic.
    [CapstonePCB.kicad_pcb, CapstonePCB.kicad_sch]
2025-10-02 Added a barrel jack for connection to wall power.
    [CapstonePCB.kicad_pcb, CapstonePCB.kicad_sch]
2025-10-03 Added Bill of Materals and reference designs
    [Motor Driver Project REV. 1.4.kicad_pcb, Motor Driver Project REV. 1.4.kicad_sch]
2025-10-03 Added barrel jack connector
    [CapstonePCB.kicad_pcb, CapstonePCB.kicad_sch]
2025-10-03 Rename 858_Web.pdf to IO Component Datasheets/Motor_datasheet
2025-10-03 Updated spacing for headers
    [CapstonePCB.kicad_pcb, CapstonePCB.kicad_sch]
2025-10-03 Added Driver Datasheet
2025-10-03 Updated formating for stm32
    [CapstonePCB.kicad_pcb, CapstonePCB.kicad_sch]
2025-10-03 Added motor driver to schematic
    [CapstonePCB.kicad_sch]
2025-10-03 Routed connections for header pins
    [CapstonePCB.kicad_pcb, CapstonePCB.kicad_sch]
2025-10-03 Added by-pass capacitors
    [CapstonePCB.kicad_pcb, CapstonePCB.kicad_sch]
2025-10-05 Added RC filter + schmitt trigger
    [CapstonePCB.kicad_sch]
2025-10-05 Added LDOs for 5v and 3.3v rails
    [CapstonePCB.kicad_pcb, CapstonePCB.kicad_sch]
2025-10-05 Added RGB led to schematic
    [CapstonePCB.kicad_pcb, CapstonePCB.kicad_sch]
2025-10-05 Added I2C light sensor to schematic
    [CapstonePCB.kicad_pcb, CapstonePCB.kicad_sch]
2025-10-05 Added footprints to motor driver circuit components
    [CapstonePCB.kicad_pcb, CapstonePCB.kicad_sch]
2025-10-05 Added in component for 8 bit schmitt trigger for button debouncing
    [CapstonePCB.kicad_pcb, CapstonePCB.kicad_sch]
2025-10-05 Formatting for pcb footprint of 8 bit schmitt trigger.
    [CapstonePCB.kicad_pcb]
2025-10-05 Added power connection for mspm0 microcontroller
    [CapstonePCB.kicad_sch]
2025-10-05 Added a ground plane
    [CapstonePCB.kicad_pcb, CapstonePCB.kicad_sch]
2025-10-06 Updated routing for PCB
    [CapstonePCB.kicad_pcb, CapstonePCB.kicad_sch]
2025-10-06 Additional routing for PCB
    [CapstonePCB.kicad_pcb]
2025-10-06 Updated button routing
    [CapstonePCB.kicad_pcb, CapstonePCB.kicad_sch]
2025-10-06 Updated naming on silkscreen
    [CapstonePCB.kicad_sch]
2025-10-06 Updated rounting
    [CapstonePCB.kicad_pcb, CapstonePCB.kicad_sch]
2025-10-13 Formatting change
    [CapstonePCB.kicad_pcb, CapstonePCB.kicad_sch]
2025-10-13 Changed caps to through-hole
    [CapstonePCB.kicad_pcb, CapstonePCB.kicad_sch]
2025-10-13 Added LCD connector to schematic
    [CapstonePCB.kicad_pcb, CapstonePCB.kicad_sch]
2025-10-13 Added power supply for LCD
    [CapstonePCB.kicad_pcb, CapstonePCB.kicad_sch]
2025-10-13 Completed routing for PCB
    [CapstonePCB.kicad_pcb, CapstonePCB.kicad_sch]
2025-10-13 Removed right angle traces
    [CapstonePCB.kicad_pcb]
2025-10-13 Updated silk-screen
    [CapstonePCB.kicad_pcb]
2025-10-13 Changed I2C light sensor to different type so pin spacing is not an issue
    [CapstonePCB.kicad_pcb, CapstonePCB.kicad_sch]
2025-10-14 Added backlight power for LCD
    [CapstonePCB.kicad_pcb, CapstonePCB.kicad_sch]
2025-10-14 Changed buttons to use 3.3V logic
    [CapstonePCB.kicad_pcb, CapstonePCB.kicad_sch]
2025-10-14 Added the buzzer driver
    [CapstonePCB.kicad_pcb, CapstonePCB.kicad_sch]
2025-10-14 Corrected edge cuts layer
    [CapstonePCB.kicad_pcb, CapstonePCB.kicad_sch]
2025-10-14 Added pin labels to the silkscreen
    [CapstonePCB.kicad_pcb]
2025-10-14 Changed formating of silkscreen
    [CapstonePCB.kicad_pcb]
2025-10-14 Added LCD area to the silkscreen
    [CapstonePCB.kicad_pcb, CapstonePCB.kicad_sch]
2025-10-14 Silkscreen formatting
    [CapstonePCB.kicad_pcb]
2025-10-15 Corrected wiring for display for 4 SPI wire
    [CapstonePCB.kicad_pcb, CapstonePCB.kicad_sch]
2025-10-15 Fixed error in routing
    [CapstonePCB.kicad_pcb]
2025-10-16 Added mic component
    [CapstonePCB.kicad_pcb, CapstonePCB.kicad_sch]
2025-10-16 Added correct footprint for STM board
    [CapstonePCB.kicad_pcb, CapstonePCB.kicad_sch]
2025-10-16 Changed to use through-hole instead of surface mount
    [CapstonePCB.kicad_pcb, CapstonePCB.kicad_sch]
2025-10-16 Corrected traces
    [CapstonePCB.kicad_pcb, CapstonePCB.kicad_sch]
2025-10-17 Made PCB smaller
    [CapstonePCB.kicad_pcb]
2025-10-20 Moved keypads location
    [CapstonePCB.kicad_pcb, CapstonePCB.kicad_sch]
2025-10-20 Updated keypad location
    [CapstonePCB.kicad_pcb]
2025-10-21 Forgot one cap that was surface mount
    [CapstonePCB.kicad_pcb, CapstonePCB.kicad_sch]
2025-10-21 Format fixes
    [CapstonePCB.kicad_pcb]
2025-10-21 Generated a BOM
    [CapstonePCB.csv]
2025-10-21 Added bypass caps to 3.3v source
    [CapstonePCB.kicad_pcb, CapstonePCB.kicad_sch]
2025-10-22 Changed position of bypass capacitors
    [CapstonePCB.kicad_pcb]
2025-10-27 Added first version of Motor Controller
2025-10-28 Updated mic to use boards 3.3v instead of development board.
    [CapstonePCB.kicad_pcb, CapstonePCB.kicad_sch]
2025-10-28 Finised first motor driver prototype
2025-11-08 added STM32 button solution
2025-11-10 PCB update
2025-11-11 Added a second revision kicad project
    [PCBRev2.csv, PCBRev2.kicad_pcb, PCBRev2.kicad_sch]
2025-11-20 Routing for second revision of the PCB
    [PCBRev2.kicad_pcb, PCBRev2.kicad_sch]
2025-11-20 Updated routing and footprints for 2nd PCB revision
    [PCBRev2.kicad_pcb, PCBRev2.kicad_sch]
2025-11-20 Added silkscreen references
    [PCBRev2.kicad_pcb]
2025-11-20 Updated silkscreen
    [PCBRev2.kicad_pcb, PCBRev2.kicad_sch]
2025-11-20 Updated PCB
    [PCBRev2.kicad_pcb]
2025-12-01 Finished light sensor code
2025-12-03 Updates to PCB
