MilesMayhew/Pedagogical-PCB/(notices)

Notices in the files:
STM32 Software Solutions/Joystick/Core/Src/main.c:
Copyright (c) 2025 STMicroelectronics.
All rights reserved.
This software is licensed under terms that can be found in the LICENSE file
